KunstGraveren/easybox/instructions-images/circuit-red-to-led.png

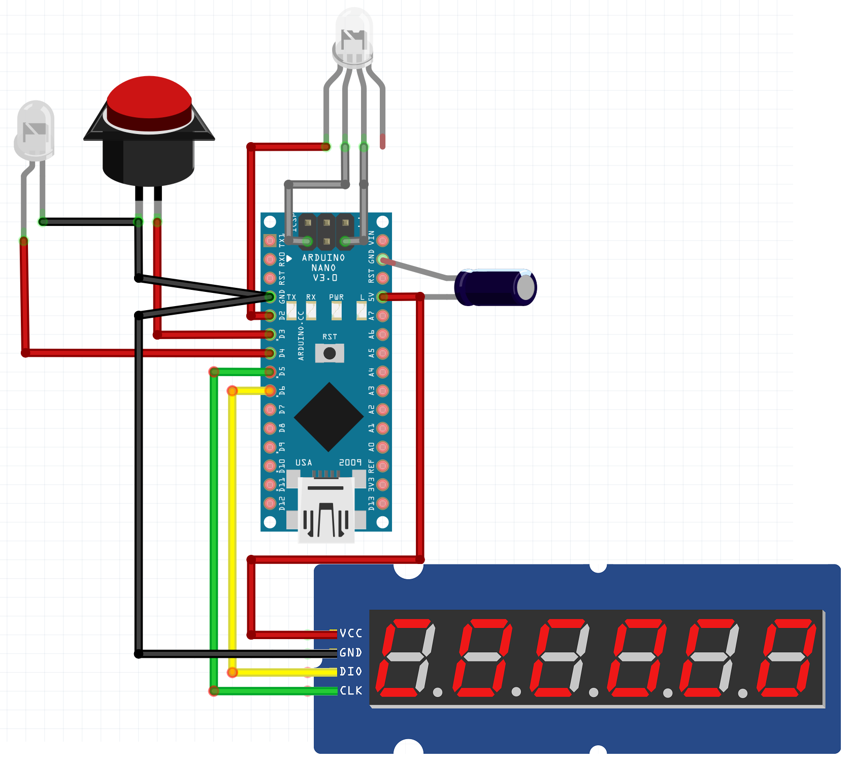
instructions-images/circuit-red-to-led.png
