KunstGraveren/easybox/instructions-images/circuit-yellow-to-led.png

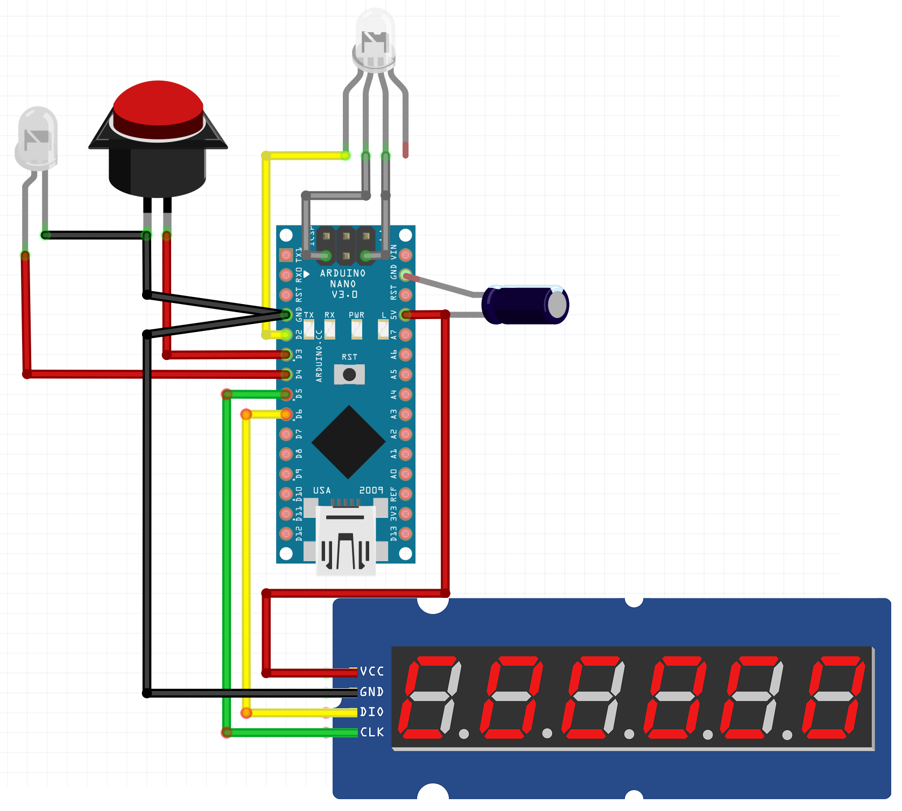
instructions-images/circuit-yellow-to-led.png
