KunstGraveren/easybox/instructions-images/montage-voorkant-bouten.png

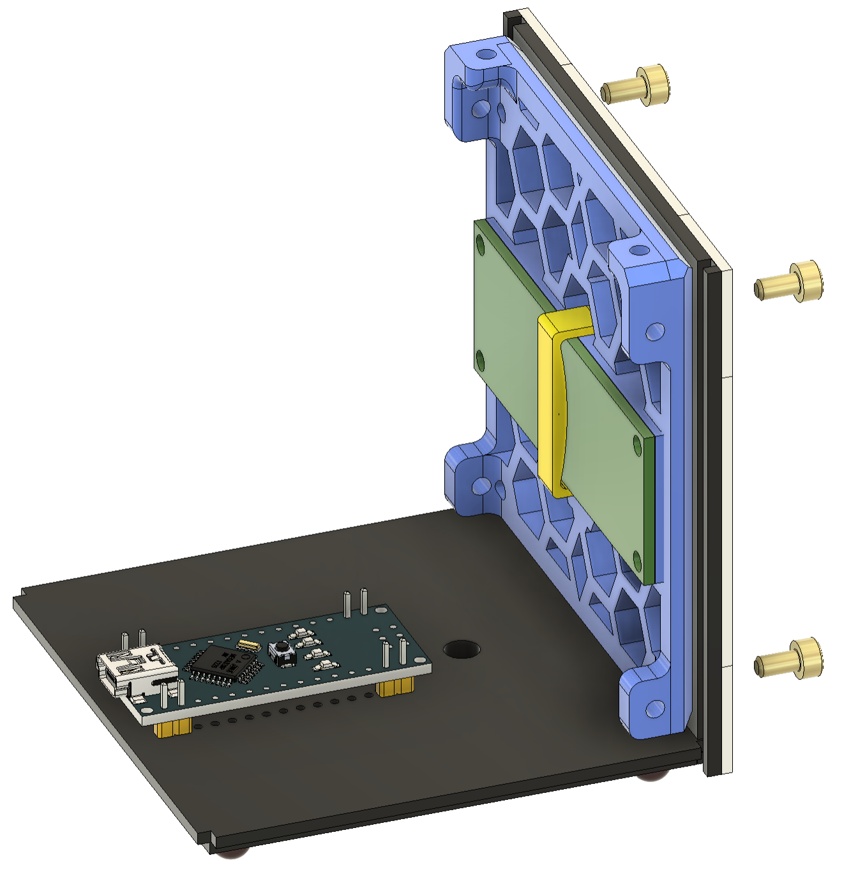
instructions-images/montage-voorkant-bouten.png
