KunstGraveren/easybox/instructions-images/soldering-positie-lcd-vs-bodem.png

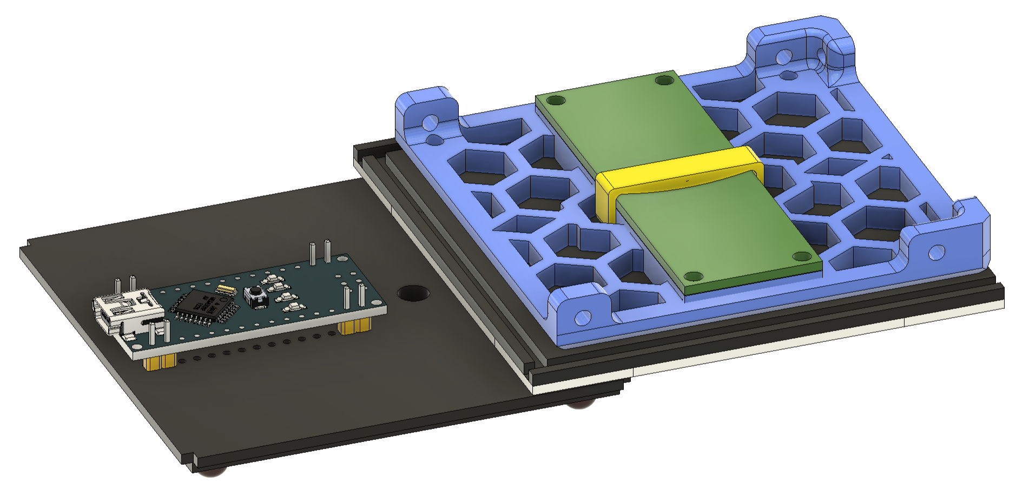
instructions-images/soldering-positie-lcd-vs-bodem.png
